seil-cse-iitb/SmartDoor/ReadMe.txt

FolderName - Description
Arduino - 2 Scripts to be run on Uno and Mega Arduinos
RaspberryPi - Client Scripts
Report - MTP Report and Presentation
Server - Server Scripts
